Paulo-Pecegueiro/Bode_Analyzer_STM32G474/Firmware/TCC_BODE_ANALYZER_G474/TouchGFX/assets/images/Graphic.png

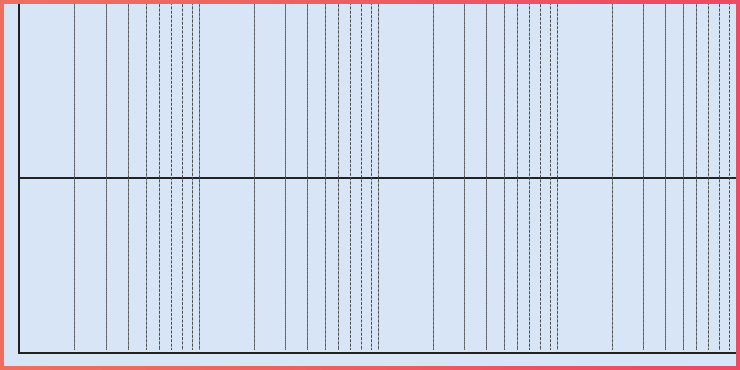
Firmware/TCC_BODE_ANALYZER_G474/TouchGFX/assets/images/Graphic.png
