Paulo-Pecegueiro/Bode_Analyzer_STM32G474/Hardware/Display/Info.png

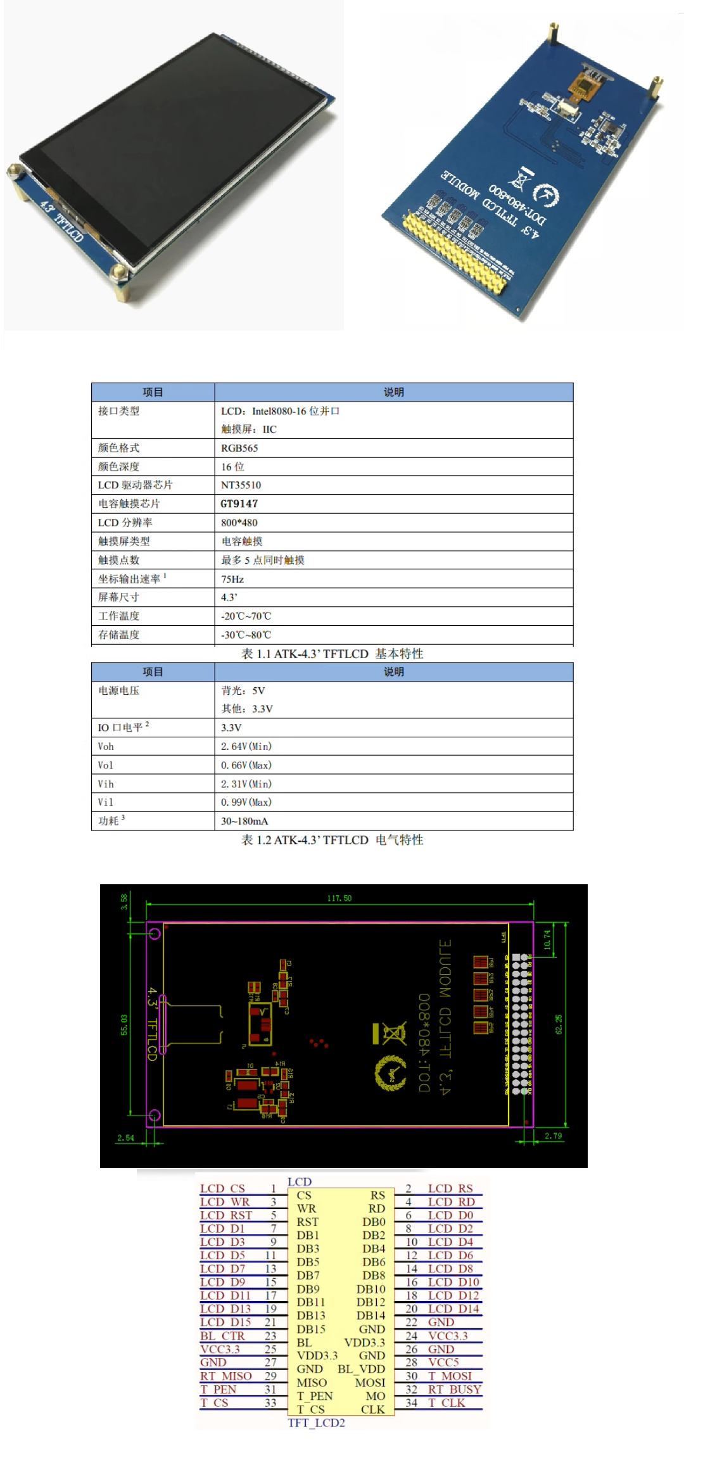
Hardware/Display/Info.png
