Paulo-Pecegueiro/Bode_Analyzer_STM32G474/Hardware/Display/Instituto_Federal_de_São_Paulo_-_Marca_Vertical_2015.bmp

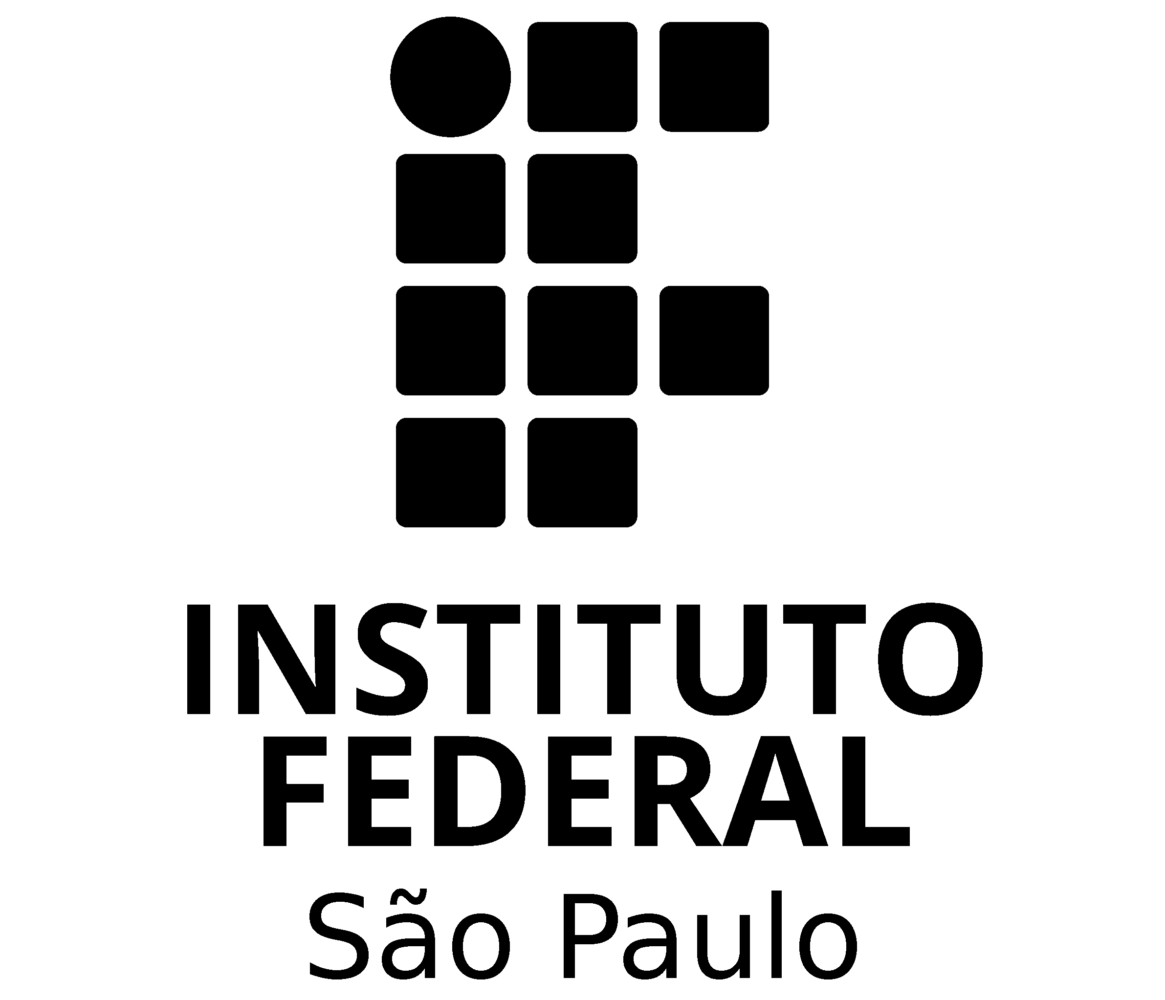
Hardware/Display/Instituto_Federal_de_São_Paulo_-_Marca_Vertical_2015.bmp
