Paulo-Pecegueiro/Bode_Analyzer_STM32G474/Hardware/Production Files/BOM.xlsx

Comment | Designator | Footprint | JLCPCB Part #（optional）
 | C1,C2,C5,C6,C10,C13,C14,C15,C16,C17,C18,C19,C22,C23,C26,C43,C46,C50,C51,C55,C58 | 0603_CAP | C14663
 | C3,C8,C11,C24,C28,C37,C41,C47,C48,C49,C53,C56 | CAPC3216X140 | C96123
 | C4,C7,C9,C12,C25,C29,C38,C40,C42,C45,C52,C54,C57 | CAPC1608X87 | C15849
 | C20,C21 | CAPC1005X55 | C1547
 | C27,C36 | CAPAE830X1080N | C136294
 | C30,C44 | CAPC3216X140 | C23630
 | C31,C32,C33,C34 | CAPC1608X87 | C38523
 | C35 | CAPPRD250W50D630H1270 | C250970
 | C59,C60,C61,C62 | 0603_CAP | C1604
 | R1,R2 | RESC1608X50A | C23186
 | R3 | RESC1608X50A | C21189
 | R4,R39,R40,R41,R42,R43,R44,R45,R46,R47 | RESC1608X50A | C23206
 | R5 | RESC1005X40 | C25079
 | R6,R7,R55,R56,R57,R58,R63,R64,R65,R66 | RESC1608X50A | C22765
 | R8,R9,R10,R11,R12,R13,R14,R15,R16,R17,R18,R19,R20,R21,R22,R23,R24,R25,R26,R27,R28,R29,R30,R31,R32,R33,R34,R35,R36,R37,R38,R48,R49,R50,R51,R52,R53,R54 | RESC1608X50A | C23197
 | R59,R60,R61,R62 | RESC1608X50A | C21189
 | U1 | QFP50P1600X1600X160-100N | C431632
 | U2,U3 | SOT95P280X145-5N | C80670
 | U4 | SOIC127P790X216-8N | C97521
 | U5,U6 | SOIC127P600X175-8 | C63813
 | U8 | SOP65P640X120-20N | C2862562
 | D1 | SOT95P280X145-5N | C490620
 | D2 | DO214 | C8678
 | D3,D4 | SOT23 | C2500
 | B1,B2,B3 | BEADC2012X105N | C1015
 | BOOT,RESET | SKRKAEE020 | C455280
 | DEBUG,STLINK | CONN-SIL4-HIGH ANGLE | MISS
 | IN,OUT | BNC | MISS
 | J1,J2 | CONN-SIL4 | MISS
 | LCD1 | 4.3 TFT L35510 - NO DISPLAY | MISS
 | LED1,LED2 | 0805 | C84256
 | SW1 | SK3296S01L3 | C319019
 | USB | TYPE-C-31-M-12 | C165948
 | X1 | YSX321SL | C2898996
