Paulo-Pecegueiro/Bode_Analyzer_STM32G474/Hardware/Display/Display - Copy.igs

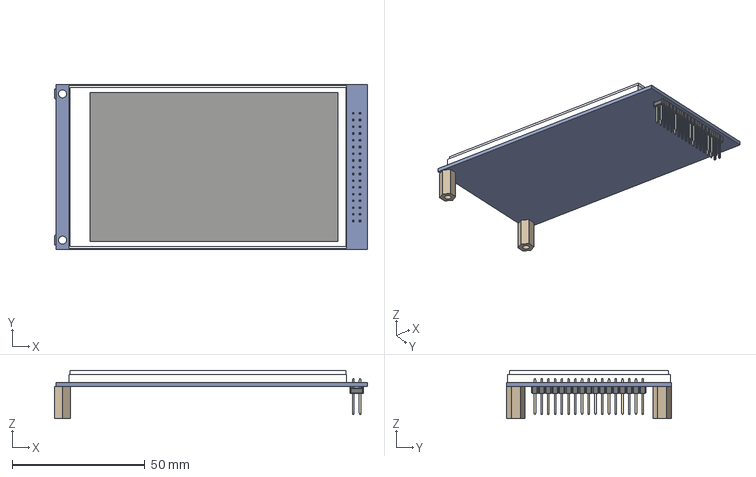
[picture p5: CAD file, 2023-12-21]
Hardware/Display/Display - Copy.igs
118.0 x 62.2 x 18.1 mm
