Paulo-Pecegueiro/Bode_Analyzer_STM32G474/Hardware/Display/2x17 Display  Connector.iges

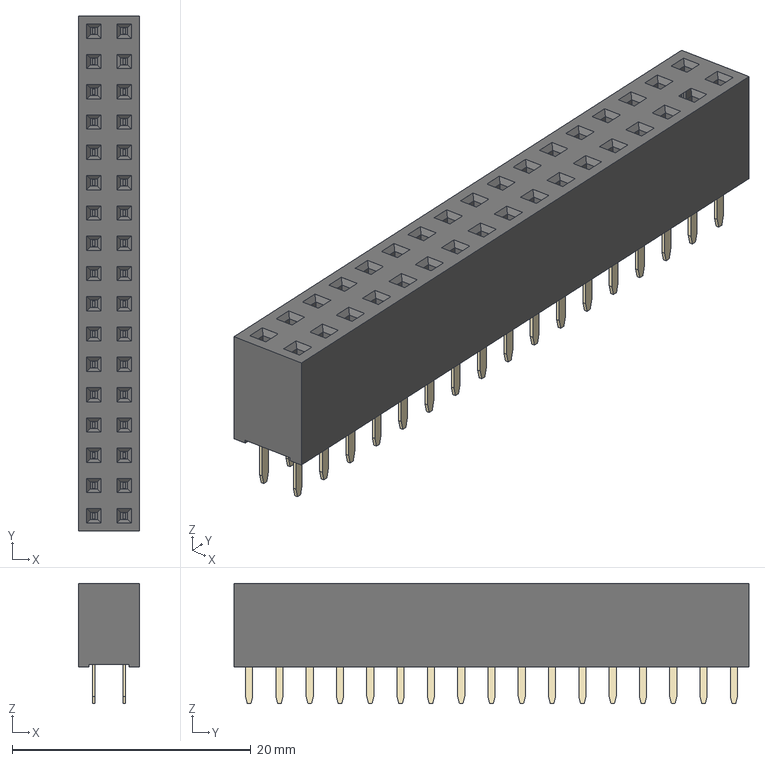
[picture p6: CAD file, 2023-12-21]
Hardware/Display/2x17 Display Connector.iges
5.08 x 43.2 x 10.1 mm
