Paulo-Pecegueiro/Bode_Analyzer_STM32G474/(list of files, cad)

Other CAD files:
Hardware/Display/Display.dwg
