Paulo-Pecegueiro/Bode_Analyzer_STM32G474/Hardware/Production Files/Bode Analyzer.PDF

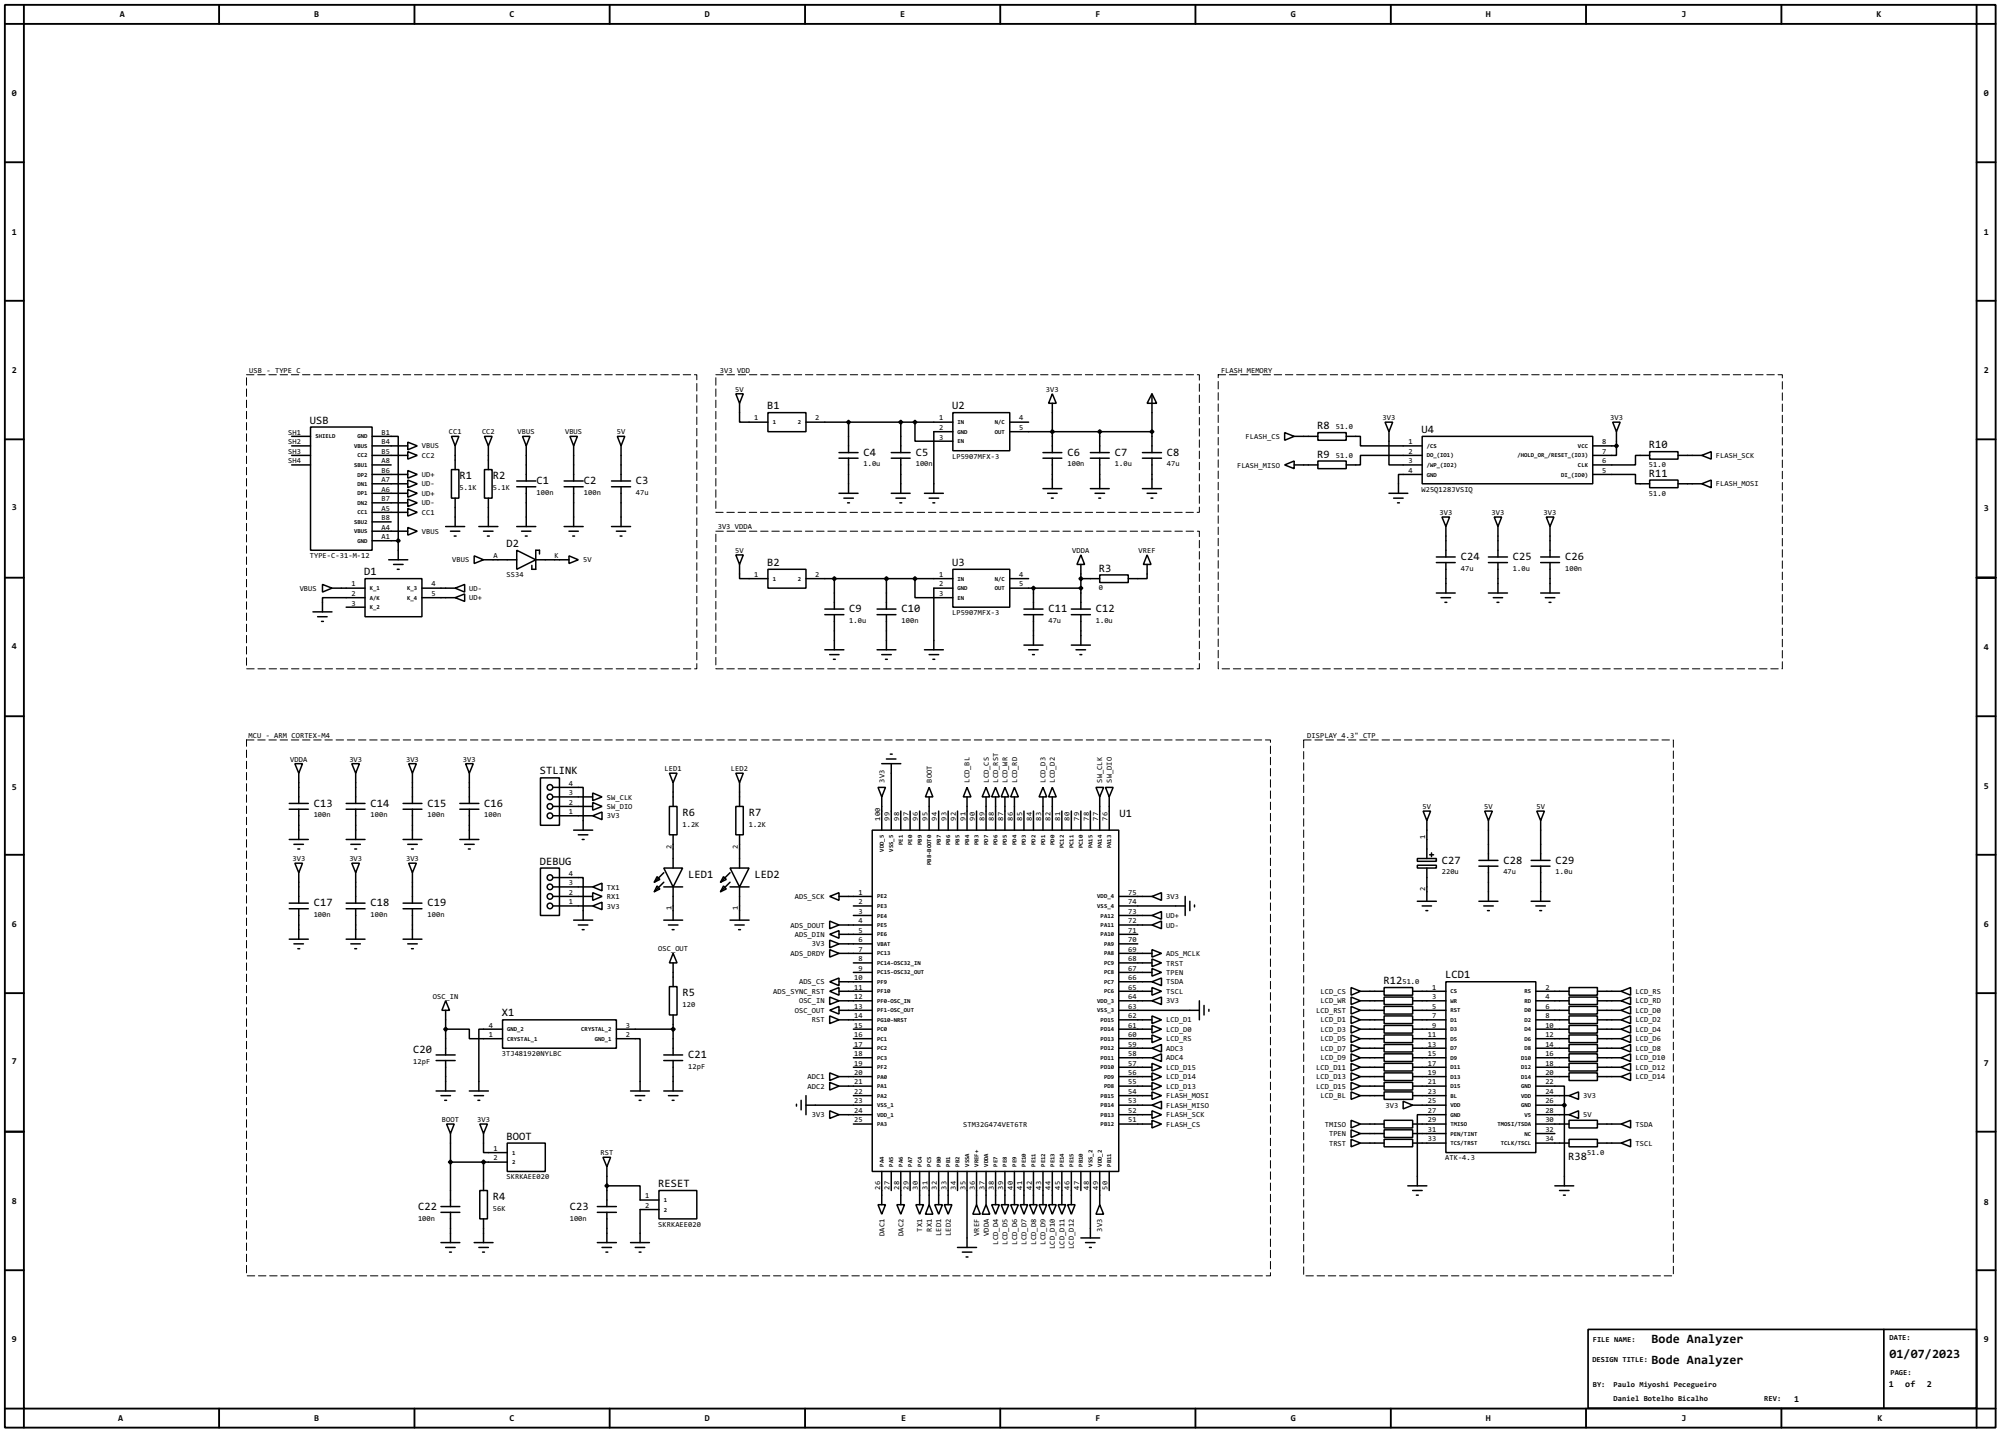
[picture p7: page 1]

DESIGN TITLE: Bode Analyzer

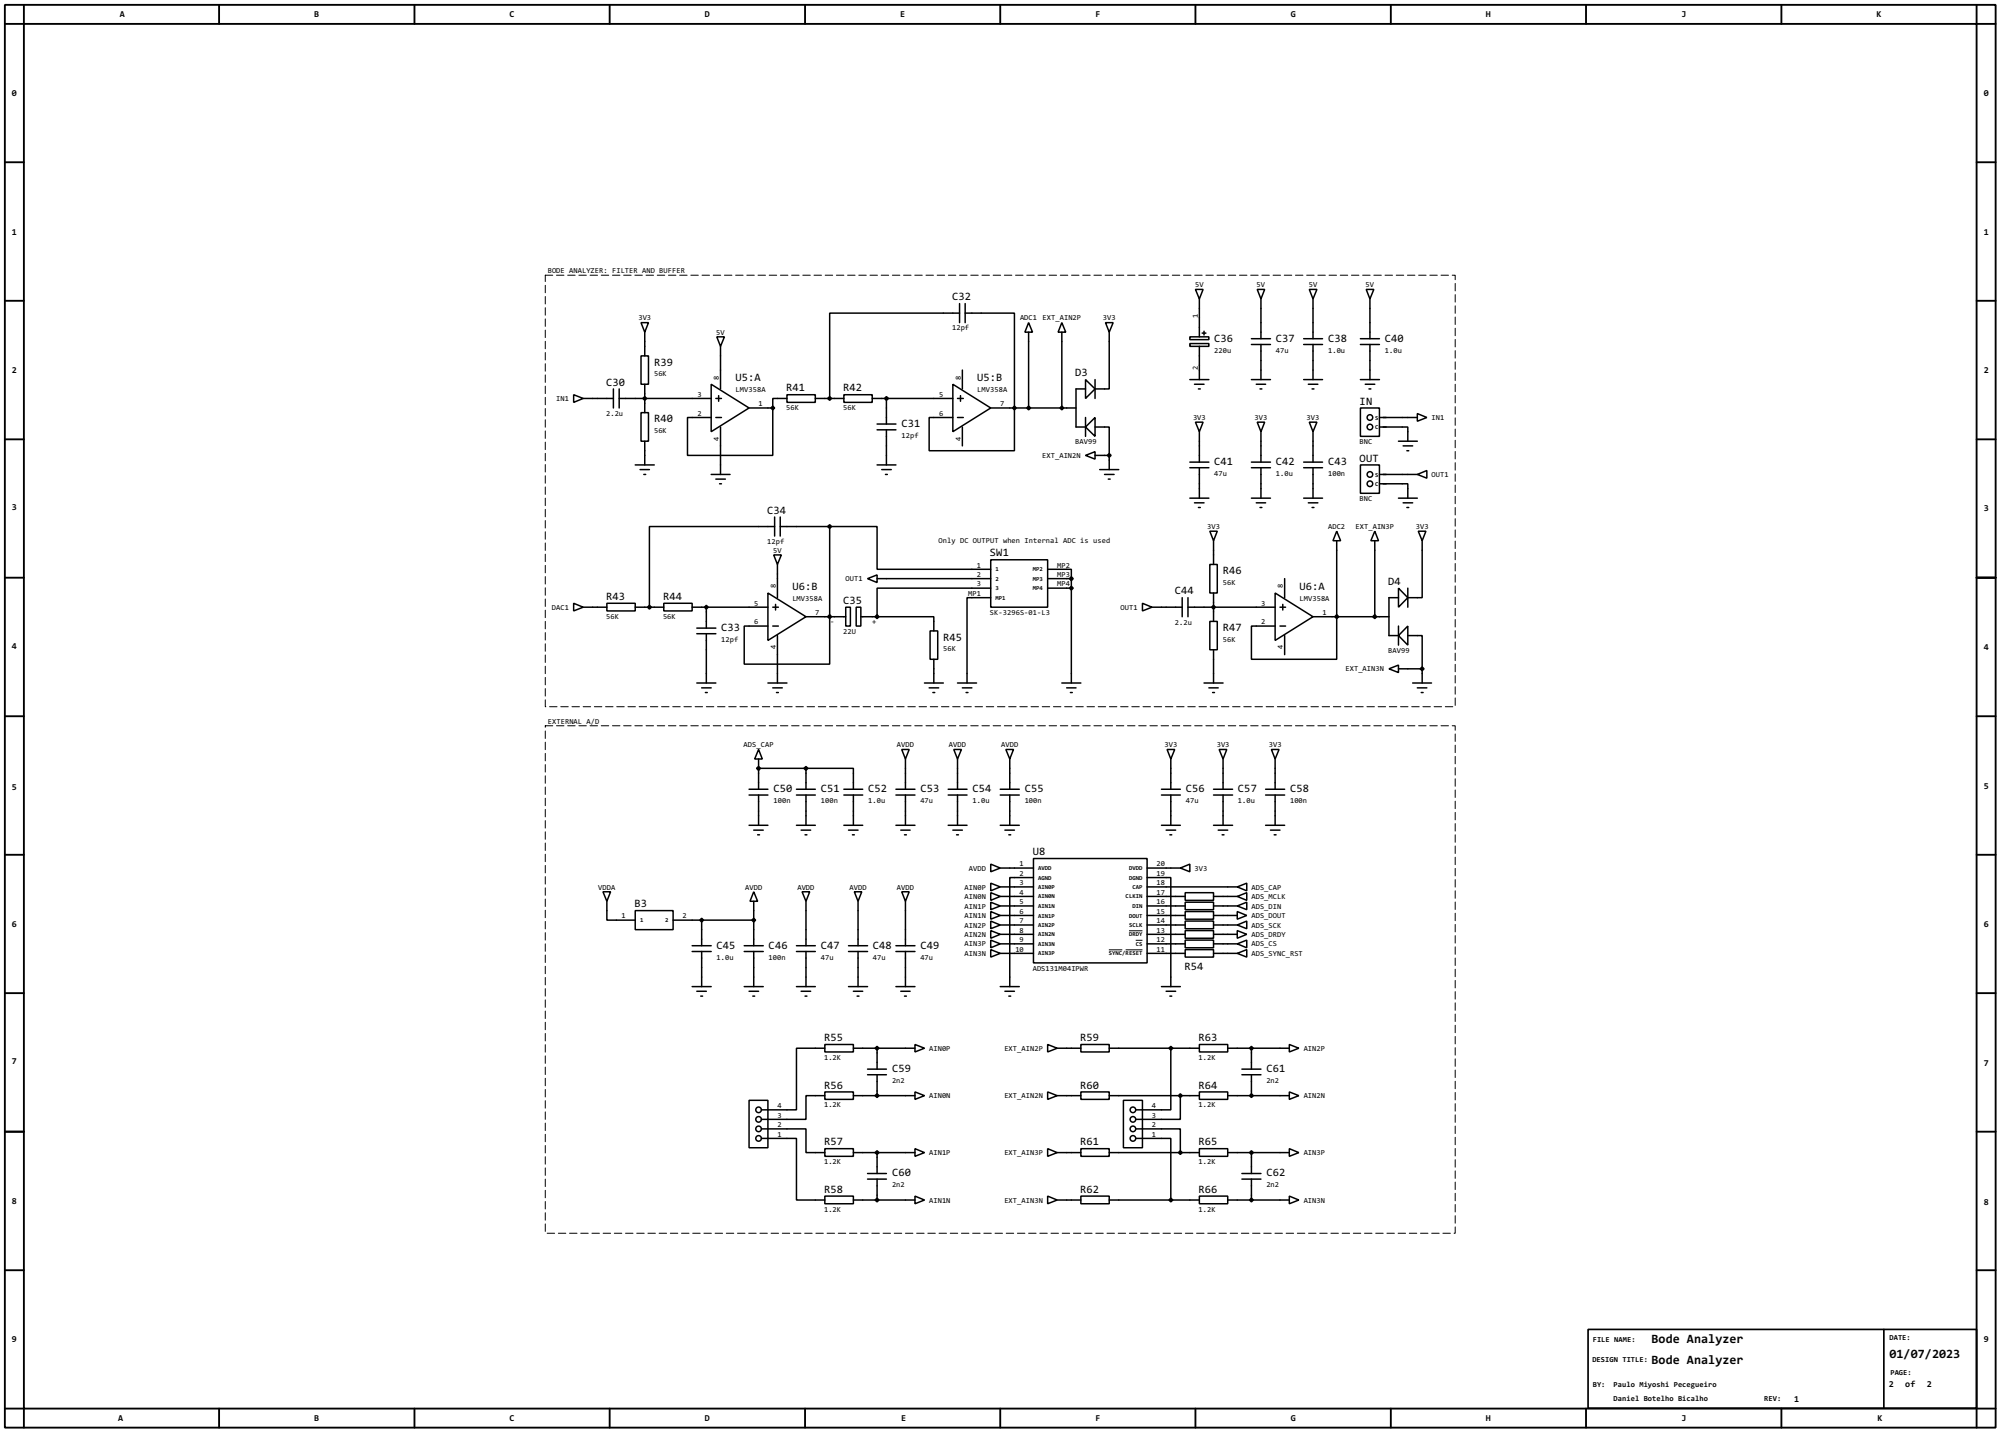
[picture p8: page 2]

BODE ANALYZER: FILTER AND BUFFER

3 3
MP1

DESIGN TITLE: Bode Analyzer
