Paulo-Pecegueiro/Bode_Analyzer_STM32G474/Arquitetura/diagrama de blocos.drawio.pdf

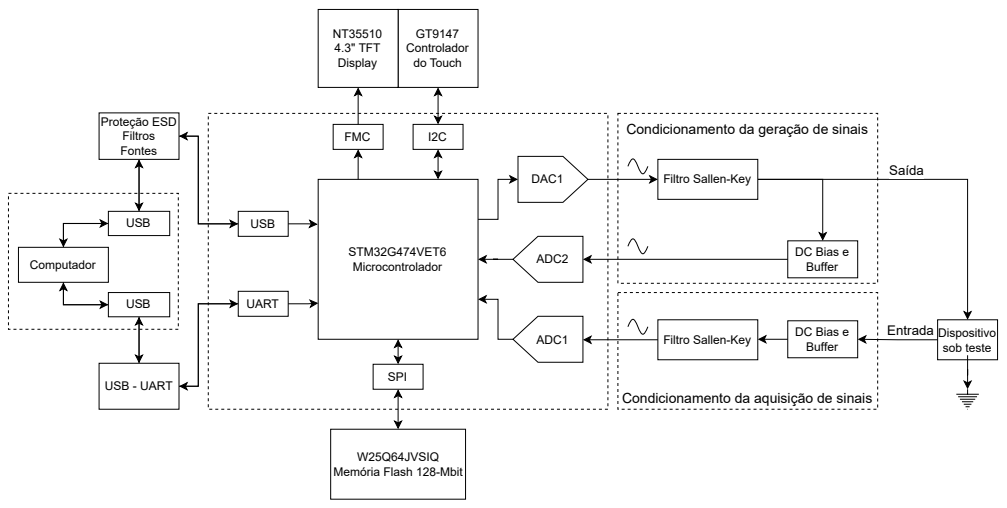
[picture p9: page 1]
STM32G474VET6 Microcontrolador; GT9147 Controlador do Touch; NT35510 4.3" TFT Display; ADC2; DAC1; ADC1; Entrada Dispositivo; sob teste; USB; Computador; SPI; FMC; UART; Saída; Proteção ESD Filtros Fontes; USB - UART; DC Bias e Buffer

Condicionamento da geração de sinais

Filtro Sallen-Key

Condicionamento da aquisição de sinais

W25Q64JVSIQ
Memória Flash 128-Mbit
