Paulo-Pecegueiro/Bode_Analyzer_STM32G474/(list of files, drawings)

Other design files:
Hardware/Hardware.pdsprj
