Paulo-Pecegueiro/Bode_Analyzer_STM32G474/Firmware/TCC_BODE_ANALYZER_G474/TCC_BODE_ANALYZER_G474.ioc

Mcu.UserName=STM32G474VETx
PA0.GPIO_Label=ADC1
PA0.Signal=ADC1_IN1
PA1.GPIO_Label=ADC2
PA1.Signal=ADC2_IN2
PA11.Signal=USB_DM
PA12.Signal=USB_DP
PA13.Signal=SYS_JTMS-SWDIO
PA14.Signal=SYS_JTCK-SWCLK
PA4.GPIO_Label=DAC1
PA4.Signal=COMP_DAC11_group
PB0.GPIO_Label=LED1
PB0.Signal=GPIO_Output
PB1.GPIO_Label=LED2
PB1.Signal=GPIO_Output
PB12.GPIO_Label=FLASH_CS
PB12.Signal=GPIO_Output
PB13.GPIO_Label=FLASH_SCK
PB13.Signal=SPI2_SCK
PB14.GPIO_Label=FLASH_MISO
PB14.Signal=SPI2_MISO
PB15.GPIO_Label=FLASH_MOSI
PB15.Signal=SPI2_MOSI
PB4.GPIO_Label=LCD_BL
PB4.Signal=S_TIM3_CH1
PC6.GPIO_Label=TSCL
PC6.Signal=I2C4_SCL
PC7.GPIO_Label=TSDA
PC7.Signal=I2C4_SDA
PC8.GPIO_Label=TPEN
PC8.Signal=GPXTI8
PC9.GPIO_Label=TRST
PC9.Signal=GPIO_Output
PD0.GPIO_Label=LCD_D2
PD0.Signal=FMC_D2
PD1.GPIO_Label=LCD_D3
PD1.Signal=FMC_D3
PD10.GPIO_Label=LCD_D15
PD10.Signal=FMC_D15
PD13.GPIO_Label=LCD_RS
PD13.Signal=FMC_A18
PD14.GPIO_Label=LCD_D0
PD14.Signal=FMC_D0
PD15.GPIO_Label=LCD_D1
PD15.Signal=FMC_D1
PD4.GPIO_Label=LCD_RD
PD4.Signal=FMC_NOE
PD5.GPIO_Label=LCD_WR
PD5.Signal=FMC_NWE
PD6.GPIO_Label=LCD_RST
PD6.Signal=GPIO_Output
PD7.GPIO_Label=LCD_CS
PD7.Signal=FMC_NE1
PD8.GPIO_Label=LCD_D13
PD8.Signal=FMC_D13
PD9.GPIO_Label=LCD_D14
PD9.Signal=FMC_D14
PE10.GPIO_Label=LCD_D7
PE10.Signal=FMC_D7
PE11.GPIO_Label=LCD_D8
PE11.Signal=FMC_D8
PE12.GPIO_Label=LCD_D9
PE12.Signal=FMC_D9
PE13.GPIO_Label=LCD_D10
PE13.Signal=FMC_D10
PE14.GPIO_Label=LCD_D11
PE14.Signal=FMC_D11
PE15.GPIO_Label=LCD_D12
PE15.Signal=FMC_D12
PE7.GPIO_Label=LCD_D4
PE7.Signal=FMC_D4
PE8.GPIO_Label=LCD_D5
PE8.Signal=FMC_D5
PE9.GPIO_Label=LCD_D6
PE9.Signal=FMC_D6
