Paulo-Pecegueiro/Bode_Analyzer_STM32G474/Firmware/TCC_BODE_ANALYZER_G474/Drivers/NT35510/NT35510.c

/* Includes ------------------------------------------------------------------*/
#include "NT35510.h"
#include "dma.h"
#include "tim.h"

#define RTOS_ENABLED  1

#if RTOS_ENABLED == 1
#include "cmsis_os.h"
#endif

/* Defines -------------------------------------------------------------------*/
#define LCD_BASE       	0x60000000
#define LCD_RAM        	0x60080000

#define DMA_HANDLE		hdma_memtomem_dma1_channel3
#define DMA_TXCALLBACK 	TransferCompleteDMACallback
#define TIM_HANDLE		TIM3
#define TIM_CHANNEL		TIM_CHANNEL_1
/* Private types -------------------------------------------------------------*/


/* Private variables ---------------------------------------------------------*/
FlagStatus __isTranmittingBlock = RESET;
const uint16_t fade[128] = {
		0, 0, 0, 0, 0, 0, 1, 1, 1, 1,
		1, 2, 2, 2, 2, 3, 3, 3, 4, 4,
		4, 5, 5, 5, 6, 6, 7, 7, 8, 8,
		9, 9, 10, 11, 11, 12, 13, 13, 14, 15,
		16, 17, 18, 19, 20, 21, 22, 23, 24, 26,
		27, 28, 30, 31, 33, 35, 36, 38, 40, 42,
		44, 47, 49, 51, 54, 57, 59, 62, 65, 68,
		72, 75, 79, 83, 87, 91, 95, 100, 105, 110,
		115, 121, 126, 132, 139, 145, 152, 160, 167, 175,
		183, 192, 201, 211, 220, 231, 242, 253, 265, 278,
		291, 304, 319, 334, 349, 366, 383, 401, 419, 439,
		460, 481, 504, 527, 552, 578, 605, 633, 662, 693,
		726, 760, 795, 832, 871, 912, 954, 999};

/* Private constants ---------------------------------------------------------*/
/* Private macros ------------------------------------------------------------*/
/* Imported function Prototypes ----------------------------------------------*/
void TransferCompleteDMACallback(DMA_HandleTypeDef * hdma);
void DisplayDriver_TransferCompleteCallback();

/* Privated functions --------------------------------------------------------*/
void LCD_WR_REG(uint16_t data)
{
	*(uint16_t *)LCD_BASE = data;
}

void LCD_WR_DATA(uint16_t data)
{
	*(uint16_t *)LCD_RAM = data;
}

uint16_t LCD_RD_DATA(void)
{
	return *(uint16_t *)LCD_RAM;
}

void LCD_Delay(uint32_t time)
{
#if RTOS_ENABLED == 1
	osDelay(time);
#else
	HAL_Delay(time);
#endif
}

void TransferCompleteDMACallback(DMA_HandleTypeDef * hdma)
{
	__HAL_DMA_CLEAR_FLAG(&DMA_HANDLE, DMA_FLAG_TC1);

	__HAL_DMA_DISABLE(&DMA_HANDLE);

	__isTranmittingBlock = RESET;

	DisplayDriver_TransferCompleteCallback();
}

void NT35510_Gamma_Correction(void)
{
		/* MAUCCTR: Enable the Manufacture Command Set Selection - Page 1 */
	LCD_WR_REG(0xF000); LCD_WR_DATA(0x55);
	LCD_WR_REG(0xF001); LCD_WR_DATA(0xAA);
	LCD_WR_REG(0xF002); LCD_WR_DATA(0x52);
	LCD_WR_REG(0xF003); LCD_WR_DATA(0x08);
	LCD_WR_REG(0xF004); LCD_WR_DATA(0x01);

	/* BT1CTR: Power Control for AVDD */
	LCD_WR_REG(0xB600); LCD_WR_DATA(0x34);
	LCD_WR_REG(0xB601); LCD_WR_DATA(0x34);
	LCD_WR_REG(0xB602); LCD_WR_DATA(0x34);

	/* SETAVDD: Setting AVDD Voltage */
	LCD_WR_REG(0xB000); LCD_WR_DATA(0x0D);
	LCD_WR_REG(0xB001); LCD_WR_DATA(0x0D);
	LCD_WR_REG(0xB002); LCD_WR_DATA(0x0D);

	/* BT2CTR Power Control for AVEE */
	LCD_WR_REG(0xB700); LCD_WR_DATA(0x24);
	LCD_WR_REG(0xB701); LCD_WR_DATA(0x24);
	LCD_WR_REG(0xB702); LCD_WR_DATA(0x24);

	/* SETAVEE: Setting AVEE Voltage */
	LCD_WR_REG(0xB100); LCD_WR_DATA(0x0D);
	LCD_WR_REG(0xB101); LCD_WR_DATA(0x0D);
	LCD_WR_REG(0xB102); LCD_WR_DATA(0x0D);

	/* BT3CTR: Power Control for VCL */
	LCD_WR_REG(0xB800); LCD_WR_DATA(0x24);
	LCD_WR_REG(0xB801); LCD_WR_DATA(0x24);
	LCD_WR_REG(0xB802); LCD_WR_DATA(0x24);

	/* SETVCL: Setting VCL Voltage */
	LCD_WR_REG(0xB200); LCD_WR_DATA(0x00);

	/* BT4CTR: Power Control for VGH */
	LCD_WR_REG(0xB900); LCD_WR_DATA(0x24);
	LCD_WR_REG(0xB901); LCD_WR_DATA(0x24);
	LCD_WR_REG(0xB902); LCD_WR_DATA(0x24);

	/* ?  */
	LCD_WR_REG(0xB300); LCD_WR_DATA(0x05);
	LCD_WR_REG(0xB301); LCD_WR_DATA(0x05);
	LCD_WR_REG(0xB302); LCD_WR_DATA(0x05);

	/* ? */
	//LCD_WR_REG(0xBF00); LCD_WR_DATA(0x01);

	/* BT5CTR: Power Control for VGLX */
	LCD_WR_REG(0xBA00); LCD_WR_DATA(0x34);
	LCD_WR_REG(0xBA01); LCD_WR_DATA(0x34);
	LCD_WR_REG(0xBA02); LCD_WR_DATA(0x34);

	/* ? */
	LCD_WR_REG(0xB500); LCD_WR_DATA(0x0B);
	LCD_WR_REG(0xB501); LCD_WR_DATA(0x0B);
	LCD_WR_REG(0xB502); LCD_WR_DATA(0x0B);

	/* STVGP: Setting VGMP and VGSP Voltage */
	LCD_WR_REG(0xBC00); LCD_WR_DATA(0X00);
	LCD_WR_REG(0xBC01); LCD_WR_DATA(0xA3);
	LCD_WR_REG(0xBC02); LCD_WR_DATA(0X00);

	/* SETVGN: Setting VGMN and VGSN Voltage */
	LCD_WR_REG(0xBD00); LCD_WR_DATA(0x00);
	LCD_WR_REG(0xBD01); LCD_WR_DATA(0xA3);
	LCD_WR_REG(0xBD02); LCD_WR_DATA(0x00);

	/* STVCMOFF: Setting VCOM Offset Voltage */
	LCD_WR_REG(0xBE00); LCD_WR_DATA(0x00);
	LCD_WR_REG(0xBE01); LCD_WR_DATA(0x63);

	/* GMRCTR1: Setting Gamma 2.2 Correction for Red (Positive) */
	LCD_WR_REG(0xD100); LCD_WR_DATA(0x00);
	LCD_WR_REG(0xD101); LCD_WR_DATA(0x37);
	LCD_WR_REG(0xD102); LCD_WR_DATA(0x00);
	LCD_WR_REG(0xD103); LCD_WR_DATA(0x52);
	LCD_WR_REG(0xD104); LCD_WR_DATA(0x00);
	LCD_WR_REG(0xD105); LCD_WR_DATA(0x7B);
	LCD_WR_REG(0xD106); LCD_WR_DATA(0x00);
	LCD_WR_REG(0xD107); LCD_WR_DATA(0x99);
	LCD_WR_REG(0xD108); LCD_WR_DATA(0x00);
	LCD_WR_REG(0xD109); LCD_WR_DATA(0xB1);
	LCD_WR_REG(0xD10A); LCD_WR_DATA(0x00);
	LCD_WR_REG(0xD10B); LCD_WR_DATA(0xD2);
	LCD_WR_REG(0xD10C); LCD_WR_DATA(0x00);
	LCD_WR_REG(0xD10D); LCD_WR_DATA(0xF6);
	LCD_WR_REG(0xD10E); LCD_WR_DATA(0x01);
	LCD_WR_REG(0xD10F); LCD_WR_DATA(0x27);
	LCD_WR_REG(0xD110); LCD_WR_DATA(0x01);
	LCD_WR_REG(0xD111); LCD_WR_DATA(0x4E);
	LCD_WR_REG(0xD112); LCD_WR_DATA(0x01);
	LCD_WR_REG(0xD113); LCD_WR_DATA(0x8C);
	LCD_WR_REG(0xD114); LCD_WR_DATA(0x01);
	LCD_WR_REG(0xD115); LCD_WR_DATA(0xBE);
	LCD_WR_REG(0xD116); LCD_WR_DATA(0x02);
	LCD_WR_REG(0xD117); LCD_WR_DATA(0x0B);
	LCD_WR_REG(0xD118); LCD_WR_DATA(0x02);
	LCD_WR_REG(0xD119); LCD_WR_DATA(0x48);
	LCD_WR_REG(0xD11A); LCD_WR_DATA(0x02);
	LCD_WR_REG(0xD11B); LCD_WR_DATA(0x4A);
	LCD_WR_REG(0xD11C); LCD_WR_DATA(0x02);
	LCD_WR_REG(0xD11D); LCD_WR_DATA(0x7E);
	LCD_WR_REG(0xD11E); LCD_WR_DATA(0x02);
	LCD_WR_REG(0xD11F); LCD_WR_DATA(0xBC);
	LCD_WR_REG(0xD120); LCD_WR_DATA(0x02);
	LCD_WR_REG(0xD121); LCD_WR_DATA(0xE1);
	LCD_WR_REG(0xD122); LCD_WR_DATA(0x03);
	LCD_WR_REG(0xD123); LCD_WR_DATA(0x10);
	LCD_WR_REG(0xD124); LCD_WR_DATA(0x03);
	LCD_WR_REG(0xD125); LCD_WR_DATA(0x31);
	LCD_WR_REG(0xD126); LCD_WR_DATA(0x03);
	LCD_WR_REG(0xD127); LCD_WR_DATA(0x5A);
	LCD_WR_REG(0xD128); LCD_WR_DATA(0x03);
	LCD_WR_REG(0xD129); LCD_WR_DATA(0x73);
	LCD_WR_REG(0xD12A); LCD_WR_DATA(0x03);
	LCD_WR_REG(0xD12B); LCD_WR_DATA(0x94);
	LCD_WR_REG(0xD12C); LCD_WR_DATA(0x03);
	LCD_WR_REG(0xD12D); LCD_WR_DATA(0x9F);
	LCD_WR_REG(0xD12E); LCD_WR_DATA(0x03);
	LCD_WR_REG(0xD12F); LCD_WR_DATA(0xB3);
	LCD_WR_REG(0xD130); LCD_WR_DATA(0x03);
	LCD_WR_REG(0xD131); LCD_WR_DATA(0xB9);
	LCD_WR_REG(0xD132); LCD_WR_DATA(0x03);
	LCD_WR_REG(0xD133); LCD_WR_DATA(0xC1);

	/* GMGCTR1: Setting Gamma 2.2 Correction for Green (Positive) */
	LCD_WR_REG(0xD200); LCD_WR_DATA(0x00);
	LCD_WR_REG(0xD201); LCD_WR_DATA(0x37);
	LCD_WR_REG(0xD202); LCD_WR_DATA(0x00);
	LCD_WR_REG(0xD203); LCD_WR_DATA(0x52);
	LCD_WR_REG(0xD204); LCD_WR_DATA(0x00);
	LCD_WR_REG(0xD205); LCD_WR_DATA(0x7B);
	LCD_WR_REG(0xD206); LCD_WR_DATA(0x00);
	LCD_WR_REG(0xD207); LCD_WR_DATA(0x99);
	LCD_WR_REG(0xD208); LCD_WR_DATA(0x00);
	LCD_WR_REG(0xD209); LCD_WR_DATA(0xB1);
	LCD_WR_REG(0xD20A); LCD_WR_DATA(0x00);
	LCD_WR_REG(0xD20B); LCD_WR_DATA(0xD2);
	LCD_WR_REG(0xD20C); LCD_WR_DATA(0x00);
	LCD_WR_REG(0xD20D); LCD_WR_DATA(0xF6);
	LCD_WR_REG(0xD20E); LCD_WR_DATA(0x01);
	LCD_WR_REG(0xD20F); LCD_WR_DATA(0x27);
	LCD_WR_REG(0xD210); LCD_WR_DATA(0x01);
	LCD_WR_REG(0xD211); LCD_WR_DATA(0x4E);
	LCD_WR_REG(0xD212); LCD_WR_DATA(0x01);
	LCD_WR_REG(0xD213); LCD_WR_DATA(0x8C);
	LCD_WR_REG(0xD214); LCD_WR_DATA(0x01);
	LCD_WR_REG(0xD215); LCD_WR_DATA(0xBE);
	LCD_WR_REG(0xD216); LCD_WR_DATA(0x02);
	LCD_WR_REG(0xD217); LCD_WR_DATA(0x0B);
	LCD_WR_REG(0xD218); LCD_WR_DATA(0x02);
	LCD_WR_REG(0xD219); LCD_WR_DATA(0x48);
	LCD_WR_REG(0xD21A); LCD_WR_DATA(0x02);
	LCD_WR_REG(0xD21B); LCD_WR_DATA(0x4A);
	LCD_WR_REG(0xD21C); LCD_WR_DATA(0x02);
	LCD_WR_REG(0xD21D); LCD_WR_DATA(0x7E);
	LCD_WR_REG(0xD21E); LCD_WR_DATA(0x02);
	LCD_WR_REG(0xD21F); LCD_WR_DATA(0xBC);
	LCD_WR_REG(0xD220); LCD_WR_DATA(0x02);
	LCD_WR_REG(0xD221); LCD_WR_DATA(0xE1);
	LCD_WR_REG(0xD222); LCD_WR_DATA(0x03);
	LCD_WR_REG(0xD223); LCD_WR_DATA(0x10);
	LCD_WR_REG(0xD224); LCD_WR_DATA(0x03);
	LCD_WR_REG(0xD225); LCD_WR_DATA(0x31);
	LCD_WR_REG(0xD226); LCD_WR_DATA(0x03);
	LCD_WR_REG(0xD227); LCD_WR_DATA(0x5A);
	LCD_WR_REG(0xD228); LCD_WR_DATA(0x03);
	LCD_WR_REG(0xD229); LCD_WR_DATA(0x73);
	LCD_WR_REG(0xD22A); LCD_WR_DATA(0x03);
	LCD_WR_REG(0xD22B); LCD_WR_DATA(0x94);
	LCD_WR_REG(0xD22C); LCD_WR_DATA(0x03);
	LCD_WR_REG(0xD22D); LCD_WR_DATA(0x9F);
	LCD_WR_REG(0xD22E); LCD_WR_DATA(0x03);
	LCD_WR_REG(0xD22F); LCD_WR_DATA(0xB3);
	LCD_WR_REG(0xD230); LCD_WR_DATA(0x03);
	LCD_WR_REG(0xD231); LCD_WR_DATA(0xB9);
	LCD_WR_REG(0xD232); LCD_WR_DATA(0x03);
	LCD_WR_REG(0xD233); LCD_WR_DATA(0xC1);

	/* GMBCTR1: Setting Gamma 2.2 Correction for Blue (Positive) */
	LCD_WR_REG(0xD300); LCD_WR_DATA(0x00);
	LCD_WR_REG(0xD301); LCD_WR_DATA(0x37);
	LCD_WR_REG(0xD302); LCD_WR_DATA(0x00);
	LCD_WR_REG(0xD303); LCD_WR_DATA(0x52);
	LCD_WR_REG(0xD304); LCD_WR_DATA(0x00);
	LCD_WR_REG(0xD305); LCD_WR_DATA(0x7B);
	LCD_WR_REG(0xD306); LCD_WR_DATA(0x00);
	LCD_WR_REG(0xD307); LCD_WR_DATA(0x99);
	LCD_WR_REG(0xD308); LCD_WR_DATA(0x00);
	LCD_WR_REG(0xD309); LCD_WR_DATA(0xB1);
	LCD_WR_REG(0xD30A); LCD_WR_DATA(0x00);
	LCD_WR_REG(0xD30B); LCD_WR_DATA(0xD2);
	LCD_WR_REG(0xD30C); LCD_WR_DATA(0x00);
	LCD_WR_REG(0xD30D); LCD_WR_DATA(0xF6);
	LCD_WR_REG(0xD30E); LCD_WR_DATA(0x01);
	LCD_WR_REG(0xD30F); LCD_WR_DATA(0x27);
	LCD_WR_REG(0xD310); LCD_WR_DATA(0x01);
	LCD_WR_REG(0xD311); LCD_WR_DATA(0x4E);
	LCD_WR_REG(0xD312); LCD_WR_DATA(0x01);
	LCD_WR_REG(0xD313); LCD_WR_DATA(0x8C);
	LCD_WR_REG(0xD314); LCD_WR_DATA(0x01);
	LCD_WR_REG(0xD315); LCD_WR_DATA(0xBE);
	LCD_WR_REG(0xD316); LCD_WR_DATA(0x02);
	LCD_WR_REG(0xD317); LCD_WR_DATA(0x0B);
	LCD_WR_REG(0xD318); LCD_WR_DATA(0x02);
	LCD_WR_REG(0xD319); LCD_WR_DATA(0x48);
	LCD_WR_REG(0xD31A); LCD_WR_DATA(0x02);
	LCD_WR_REG(0xD31B); LCD_WR_DATA(0x4A);
	LCD_WR_REG(0xD31C); LCD_WR_DATA(0x02);
	LCD_WR_REG(0xD31D); LCD_WR_DATA(0x7E);
	LCD_WR_REG(0xD31E); LCD_WR_DATA(0x02);
	LCD_WR_REG(0xD31F); LCD_WR_DATA(0xBC);
	LCD_WR_REG(0xD320); LCD_WR_DATA(0x02);
	LCD_WR_REG(0xD321); LCD_WR_DATA(0xE1);
	LCD_WR_REG(0xD322); LCD_WR_DATA(0x03);
	LCD_WR_REG(0xD323); LCD_WR_DATA(0x10);
	LCD_WR_REG(0xD324); LCD_WR_DATA(0x03);
	LCD_WR_REG(0xD325); LCD_WR_DATA(0x31);
	LCD_WR_REG(0xD326); LCD_WR_DATA(0x03);
	LCD_WR_REG(0xD327); LCD_WR_DATA(0x5A);
	LCD_WR_REG(0xD328); LCD_WR_DATA(0x03);
	LCD_WR_REG(0xD329); LCD_WR_DATA(0x73);
	LCD_WR_REG(0xD32A); LCD_WR_DATA(0x03);
	LCD_WR_REG(0xD32B); LCD_WR_DATA(0x94);
	LCD_WR_REG(0xD32C); LCD_WR_DATA(0x03);
	LCD_WR_REG(0xD32D); LCD_WR_DATA(0x9F);
	LCD_WR_REG(0xD32E); LCD_WR_DATA(0x03);
	LCD_WR_REG(0xD32F); LCD_WR_DATA(0xB3);
	LCD_WR_REG(0xD330); LCD_WR_DATA(0x03);
	LCD_WR_REG(0xD331); LCD_WR_DATA(0xB9);
	LCD_WR_REG(0xD332); LCD_WR_DATA(0x03);
	LCD_WR_REG(0xD333); LCD_WR_DATA(0xC1);

	/* GMRCTR2: Setting Gamma 2.2 Correction for Red (Negative) */
	LCD_WR_REG(0xD400); LCD_WR_DATA(0x00);
	LCD_WR_REG(0xD401); LCD_WR_DATA(0x37);
	LCD_WR_REG(0xD402); LCD_WR_DATA(0x00);
	LCD_WR_REG(0xD403); LCD_WR_DATA(0x52);
	LCD_WR_REG(0xD404); LCD_WR_DATA(0x00);
	LCD_WR_REG(0xD405); LCD_WR_DATA(0x7B);
	LCD_WR_REG(0xD406); LCD_WR_DATA(0x00);
	LCD_WR_REG(0xD407); LCD_WR_DATA(0x99);
	LCD_WR_REG(0xD408); LCD_WR_DATA(0x00);
	LCD_WR_REG(0xD409); LCD_WR_DATA(0xB1);
	LCD_WR_REG(0xD40A); LCD_WR_DATA(0x00);
	LCD_WR_REG(0xD40B); LCD_WR_DATA(0xD2);
	LCD_WR_REG(0xD40C); LCD_WR_DATA(0x00);
	LCD_WR_REG(0xD40D); LCD_WR_DATA(0xF6);
	LCD_WR_REG(0xD40E); LCD_WR_DATA(0x01);
	LCD_WR_REG(0xD40F); LCD_WR_DATA(0x27);
	LCD_WR_REG(0xD410); LCD_WR_DATA(0x01);
	LCD_WR_REG(0xD411); LCD_WR_DATA(0x4E);
	LCD_WR_REG(0xD412); LCD_WR_DATA(0x01);
	LCD_WR_REG(0xD413); LCD_WR_DATA(0x8C);
	LCD_WR_REG(0xD414); LCD_WR_DATA(0x01);
	LCD_WR_REG(0xD415); LCD_WR_DATA(0xBE);
	LCD_WR_REG(0xD416); LCD_WR_DATA(0x02);
	LCD_WR_REG(0xD417); LCD_WR_DATA(0x0B);
	LCD_WR_REG(0xD418); LCD_WR_DATA(0x02);
	LCD_WR_REG(0xD419); LCD_WR_DATA(0x48);
	LCD_WR_REG(0xD41A); LCD_WR_DATA(0x02);
	LCD_WR_REG(0xD41B); LCD_WR_DATA(0x4A);
	LCD_WR_REG(0xD41C); LCD_WR_DATA(0x02);
	LCD_WR_REG(0xD41D); LCD_WR_DATA(0x7E);
	LCD_WR_REG(0xD41E); LCD_WR_DATA(0x02);
	LCD_WR_REG(0xD41F); LCD_WR_DATA(0xBC);
	LCD_WR_REG(0xD420); LCD_WR_DATA(0x02);
	LCD_WR_REG(0xD421); LCD_WR_DATA(0xE1);
	LCD_WR_REG(0xD422); LCD_WR_DATA(0x03);
	LCD_WR_REG(0xD423); LCD_WR_DATA(0x10);
	LCD_WR_REG(0xD424); LCD_WR_DATA(0x03);
	LCD_WR_REG(0xD425); LCD_WR_DATA(0x31);
	LCD_WR_REG(0xD426); LCD_WR_DATA(0x03);
	LCD_WR_REG(0xD427); LCD_WR_DATA(0x5A);
	LCD_WR_REG(0xD428); LCD_WR_DATA(0x03);
	LCD_WR_REG(0xD429); LCD_WR_DATA(0x73);
	LCD_WR_REG(0xD42A); LCD_WR_DATA(0x03);
	LCD_WR_REG(0xD42B); LCD_WR_DATA(0x94);
	LCD_WR_REG(0xD42C); LCD_WR_DATA(0x03);
	LCD_WR_REG(0xD42D); LCD_WR_DATA(0x9F);
	LCD_WR_REG(0xD42E); LCD_WR_DATA(0x03);
	LCD_WR_REG(0xD42F); LCD_WR_DATA(0xB3);
	LCD_WR_REG(0xD430); LCD_WR_DATA(0x03);
	LCD_WR_REG(0xD431); LCD_WR_DATA(0xB9);
	LCD_WR_REG(0xD432); LCD_WR_DATA(0x03);
	LCD_WR_REG(0xD433); LCD_WR_DATA(0xC1);

	/* GMGCTR2: Setting Gamma 2.2 Correction for Green */
	LCD_WR_REG(0xD500); LCD_WR_DATA(0x00);
	LCD_WR_REG(0xD501); LCD_WR_DATA(0x37);
	LCD_WR_REG(0xD502); LCD_WR_DATA(0x00);
	LCD_WR_REG(0xD503); LCD_WR_DATA(0x52);
	LCD_WR_REG(0xD504); LCD_WR_DATA(0x00);
	LCD_WR_REG(0xD505); LCD_WR_DATA(0x7B);
	LCD_WR_REG(0xD506); LCD_WR_DATA(0x00);
	LCD_WR_REG(0xD507); LCD_WR_DATA(0x99);
	LCD_WR_REG(0xD508); LCD_WR_DATA(0x00);
	LCD_WR_REG(0xD509); LCD_WR_DATA(0xB1);
	LCD_WR_REG(0xD50A); LCD_WR_DATA(0x00);
	LCD_WR_REG(0xD50B); LCD_WR_DATA(0xD2);
	LCD_WR_REG(0xD50C); LCD_WR_DATA(0x00);
	LCD_WR_REG(0xD50D); LCD_WR_DATA(0xF6);
	LCD_WR_REG(0xD50E); LCD_WR_DATA(0x01);
	LCD_WR_REG(0xD50F); LCD_WR_DATA(0x27);
	LCD_WR_REG(0xD510); LCD_WR_DATA(0x01);
	LCD_WR_REG(0xD511); LCD_WR_DATA(0x4E);
	LCD_WR_REG(0xD512); LCD_WR_DATA(0x01);
	LCD_WR_REG(0xD513); LCD_WR_DATA(0x8C);
	LCD_WR_REG(0xD514); LCD_WR_DATA(0x01);
	LCD_WR_REG(0xD515); LCD_WR_DATA(0xBE);
	LCD_WR_REG(0xD516); LCD_WR_DATA(0x02);
	LCD_WR_REG(0xD517); LCD_WR_DATA(0x0B);
	LCD_WR_REG(0xD518); LCD_WR_DATA(0x02);
	LCD_WR_REG(0xD519); LCD_WR_DATA(0x48);
	LCD_WR_REG(0xD51A); LCD_WR_DATA(0x02);
	LCD_WR_REG(0xD51B); LCD_WR_DATA(0x4A);
	LCD_WR_REG(0xD51C); LCD_WR_DATA(0x02);
	LCD_WR_REG(0xD51D); LCD_WR_DATA(0x7E);
	LCD_WR_REG(0xD51E); LCD_WR_DATA(0x02);
	LCD_WR_REG(0xD51F); LCD_WR_DATA(0xBC);
	LCD_WR_REG(0xD520); LCD_WR_DATA(0x02);
	LCD_WR_REG(0xD521); LCD_WR_DATA(0xE1);
	LCD_WR_REG(0xD522); LCD_WR_DATA(0x03);
	LCD_WR_REG(0xD523); LCD_WR_DATA(0x10);
	LCD_WR_REG(0xD524); LCD_WR_DATA(0x03);
	LCD_WR_REG(0xD525); LCD_WR_DATA(0x31);
	LCD_WR_REG(0xD526); LCD_WR_DATA(0x03);
	LCD_WR_REG(0xD527); LCD_WR_DATA(0x5A);
	LCD_WR_REG(0xD528); LCD_WR_DATA(0x03);
	LCD_WR_REG(0xD529); LCD_WR_DATA(0x73);
	LCD_WR_REG(0xD52A); LCD_WR_DATA(0x03);
	LCD_WR_REG(0xD52B); LCD_WR_DATA(0x94);
	LCD_WR_REG(0xD52C); LCD_WR_DATA(0x03);
	LCD_WR_REG(0xD52D); LCD_WR_DATA(0x9F);
	LCD_WR_REG(0xD52E); LCD_WR_DATA(0x03);
	LCD_WR_REG(0xD52F); LCD_WR_DATA(0xB3);
	LCD_WR_REG(0xD530); LCD_WR_DATA(0x03);
	LCD_WR_REG(0xD531); LCD_WR_DATA(0xB9);
	LCD_WR_REG(0xD532); LCD_WR_DATA(0x03);
	LCD_WR_REG(0xD533); LCD_WR_DATA(0xC1);

	/* GMBCTR2: Setting Gamma 2.2 Correction for Blue (Negative) */
	LCD_WR_REG(0xD600); LCD_WR_DATA(0x00);
	LCD_WR_REG(0xD601); LCD_WR_DATA(0x37);
	LCD_WR_REG(0xD602); LCD_WR_DATA(0x00);
	LCD_WR_REG(0xD603); LCD_WR_DATA(0x52);
	LCD_WR_REG(0xD604); LCD_WR_DATA(0x00);
	LCD_WR_REG(0xD605); LCD_WR_DATA(0x7B);
	LCD_WR_REG(0xD606); LCD_WR_DATA(0x00);
	LCD_WR_REG(0xD607); LCD_WR_DATA(0x99);
	LCD_WR_REG(0xD608); LCD_WR_DATA(0x00);
	LCD_WR_REG(0xD609); LCD_WR_DATA(0xB1);
	LCD_WR_REG(0xD60A); LCD_WR_DATA(0x00);
	LCD_WR_REG(0xD60B); LCD_WR_DATA(0xD2);
	LCD_WR_REG(0xD60C); LCD_WR_DATA(0x00);
	LCD_WR_REG(0xD60D); LCD_WR_DATA(0xF6);
	LCD_WR_REG(0xD60E); LCD_WR_DATA(0x01);
	LCD_WR_REG(0xD60F); LCD_WR_DATA(0x27);
	LCD_WR_REG(0xD610); LCD_WR_DATA(0x01);
	LCD_WR_REG(0xD611); LCD_WR_DATA(0x4E);
	LCD_WR_REG(0xD612); LCD_WR_DATA(0x01);
	LCD_WR_REG(0xD613); LCD_WR_DATA(0x8C);
	LCD_WR_REG(0xD614); LCD_WR_DATA(0x01);
	LCD_WR_REG(0xD615); LCD_WR_DATA(0xBE);
	LCD_WR_REG(0xD616); LCD_WR_DATA(0x02);
	LCD_WR_REG(0xD617); LCD_WR_DATA(0x0B);
	LCD_WR_REG(0xD618); LCD_WR_DATA(0x02);
	LCD_WR_REG(0xD619); LCD_WR_DATA(0x48);
	LCD_WR_REG(0xD61A); LCD_WR_DATA(0x02);
	LCD_WR_REG(0xD61B); LCD_WR_DATA(0x4A);
	LCD_WR_REG(0xD61C); LCD_WR_DATA(0x02);
	LCD_WR_REG(0xD61D); LCD_WR_DATA(0x7E);
	LCD_WR_REG(0xD61E); LCD_WR_DATA(0x02);
	LCD_WR_REG(0xD61F); LCD_WR_DATA(0xBC);
	LCD_WR_REG(0xD620); LCD_WR_DATA(0x02);
	LCD_WR_REG(0xD621); LCD_WR_DATA(0xE1);
	LCD_WR_REG(0xD622); LCD_WR_DATA(0x03);
	LCD_WR_REG(0xD623); LCD_WR_DATA(0x10);
	LCD_WR_REG(0xD624); LCD_WR_DATA(0x03);
	LCD_WR_REG(0xD625); LCD_WR_DATA(0x31);
	LCD_WR_REG(0xD626); LCD_WR_DATA(0x03);
	LCD_WR_REG(0xD627); LCD_WR_DATA(0x5A);
	LCD_WR_REG(0xD628); LCD_WR_DATA(0x03);
	LCD_WR_REG(0xD629); LCD_WR_DATA(0x73);
	LCD_WR_REG(0xD62A); LCD_WR_DATA(0x03);
	LCD_WR_REG(0xD62B); LCD_WR_DATA(0x94);
	LCD_WR_REG(0xD62C); LCD_WR_DATA(0x03);
	LCD_WR_REG(0xD62D); LCD_WR_DATA(0x9F);
	LCD_WR_REG(0xD62E); LCD_WR_DATA(0x03);
	LCD_WR_REG(0xD62F); LCD_WR_DATA(0xB3);
	LCD_WR_REG(0xD630); LCD_WR_DATA(0x03);
	LCD_WR_REG(0xD631); LCD_WR_DATA(0xB9);
	LCD_WR_REG(0xD632); LCD_WR_DATA(0x03);
	LCD_WR_REG(0xD633); LCD_WR_DATA(0xC1);

	/* MAUCCTR: Enable the Manufacture Command Set Selection - Page 0 */
	LCD_WR_REG(0xF000); LCD_WR_DATA(0x55);
	LCD_WR_REG(0xF001); LCD_WR_DATA(0xAA);
	LCD_WR_REG(0xF002); LCD_WR_DATA(0x52);
	LCD_WR_REG(0xF003); LCD_WR_DATA(0x08);
	LCD_WR_REG(0xF004); LCD_WR_DATA(0x00);

	/* RGBCTR: RGB Interface Signals Control */
	LCD_WR_REG(0xB000); LCD_WR_DATA(0x08);
	LCD_WR_REG(0xB001); LCD_WR_DATA(0x05);
	LCD_WR_REG(0xB002); LCD_WR_DATA(0x02);
	LCD_WR_REG(0xB003); LCD_WR_DATA(0x05);
	LCD_WR_REG(0xB004); LCD_WR_DATA(0x02);

	/* SDHDTCTR: Source Output Data Hold Time Control */
	LCD_WR_REG(0xB600); LCD_WR_DATA(0x08);

	/* GSEQCTR: EQ Control Function for Gate Signals */
	LCD_WR_REG(0xB700); LCD_WR_DATA(0x00);
	LCD_WR_REG(0xB701); LCD_WR_DATA(0x00);

	/* SDEQCTR: EQ Control Function for Source Driver */
	LCD_WR_REG(0xB800); LCD_WR_DATA(0x01);
	LCD_WR_REG(0xB801); LCD_WR_DATA(0x05);
	LCD_WR_REG(0xB802); LCD_WR_DATA(0x05);
	LCD_WR_REG(0xB803); LCD_WR_DATA(0x05);
}

/* Exported functions --------------------------------------------------------*/
void NT35510_Init(void)
{
	/* Perform a hardware reset */
	HAL_GPIO_WritePin(LCD_RST_GPIO_Port, LCD_RST_Pin, GPIO_PIN_SET);
	LCD_Delay(100);
	HAL_GPIO_WritePin(LCD_RST_GPIO_Port, LCD_RST_Pin, GPIO_PIN_RESET);
	LCD_Delay(100);
	HAL_GPIO_WritePin(LCD_RST_GPIO_Port, LCD_RST_Pin, GPIO_PIN_SET);
	LCD_Delay(100);

	NT35510_Gamma_Correction();

	/* DPFRCTR1: Display Timing Control in Normal / Idle Off Mode */
	LCD_WR_REG(0xBD00); LCD_WR_DATA(0x01); //19.45us
	LCD_WR_REG(0xBD01); LCD_WR_DATA(0x84);
	LCD_WR_REG(0xBD02); LCD_WR_DATA(0x07); // 7 lines
	LCD_WR_REG(0xBD03); LCD_WR_DATA(0x31); // 49 lines

	/* Normal Mode On */
	LCD_WR_REG(NT35510_CMD_NORON);

	/* Tearing Effect On */
//	LCD_WR_REG(NT35510_CMD_TEEON);
//	LCD_WR_DATA(0x00);
//
//	/* Set Tear Scan Line Mode */
//	LCD_WR_REG(NT35510_CMD_STESL);
//	LCD_WR_DATA(0x00);
//	LCD_WR_REG(NT35510_CMD_STESL + 1);
//	LCD_WR_DATA(0x00);

	/* Change the color mode to RG565 */
	LCD_WR_REG(NT35510_CMD_COLMOD);
	LCD_WR_DATA(NT35510_COLMOD_RGB565);

//	LCD_WR_REG(NT35510_CMD_MADCTL);
//	LCD_WR_DATA(0x14);

	/* Send the Sleep Out Command */
	LCD_WR_REG(NT35510_CMD_SLPOUT);

	LCD_Delay(120);

	/* Turn the display on */
	LCD_WR_REG(NT35510_CMD_DISPON);

#ifdef DMA_HANDLE
	DMA_HANDLE.XferCpltCallback = DMA_TXCALLBACK;
#endif
}

void NT35510_SetWindow(uint16_t x, uint16_t y, uint16_t sizex, uint16_t sizey)
{
	LCD_WR_REG(NT35510_CMD_CASET);
	LCD_WR_DATA((x & 0xFF00) >> 8);
	LCD_WR_REG((NT35510_CMD_CASET) + 1);
	LCD_WR_DATA(x & 0x00FF);
	LCD_WR_REG((NT35510_CMD_CASET) + 2);
	LCD_WR_DATA(((x + sizex) & 0xFF00) >> 8);
	LCD_WR_REG((NT35510_CMD_CASET) + 3);
	LCD_WR_DATA((x + sizex - 1) & 0x00FF);

	LCD_WR_REG(NT35510_CMD_RASET);
	LCD_WR_DATA((y & 0xFF00) >> 8);
	LCD_WR_REG((NT35510_CMD_RASET) + 1);
	LCD_WR_DATA(y & 0x00FF);
	LCD_WR_REG((NT35510_CMD_RASET) + 2);
	LCD_WR_DATA(((y + sizey) & 0xFF00) >> 8);
	LCD_WR_REG((NT35510_CMD_RASET) + 3);
	LCD_WR_DATA((y + sizey - 1) & 0x00FF);
}

uint16_t NT35510_GetLine(void)
{
	uint32_t line;

	LCD_WR_REG(NT35510_CMD_GSL);
	line = LCD_RD_DATA() << 8;
	LCD_WR_REG(NT35510_CMD_GSL + 1);
	line |= LCD_RD_DATA();

	return line;
}

void NT35510_DMAWrite(uint16_t *pixels, uint16_t x, uint16_t y, uint16_t sizex, uint16_t sizey)
{
	__isTranmittingBlock = SET;

	NT35510_SetWindow(x, y, sizex, sizey);

	DMA_HANDLE.Instance->CMAR = (uint32_t)LCD_RAM;
	DMA_HANDLE.Instance->CPAR = (uint32_t)pixels;
	DMA_HANDLE.Instance->CNDTR = sizex * sizey;

	__HAL_DMA_ENABLE_IT(&DMA_HANDLE, DMA_IT_TC);

	LCD_WR_REG(NT35510_CMD_RAMWR);

	__HAL_DMA_ENABLE(&DMA_HANDLE);
}

void NT35510_FadeIn(uint8_t Delay)
{
	for(uint16_t i = 0; i < 128; i++)
	{
		LL_TIM_OC_SetCompareCH1(TIM_HANDLE, fade[i]);
		LCD_Delay(Delay);
	}
}

void NT35510_FadeOut(uint8_t Delay)
{
	for(uint16_t i = 128; i > 0; i--)
	{
		LL_TIM_OC_SetCompareCH1(TIM_HANDLE, fade[i]);
		LCD_Delay(Delay);
	}
}
