Paulo-Pecegueiro/Bode_Analyzer_STM32G474/Firmware/TCC_BODE_ANALYZER_G474/Core/Src/fmc.c

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

/* Includes ------------------------------------------------------------------*/
#include "fmc.h"

SRAM_HandleTypeDef hsram1;

/* FMC initialization function */
void MX_FMC_Init(void)
{
  FMC_NORSRAM_TimingTypeDef Timing = {0};
  FMC_NORSRAM_TimingTypeDef ExtTiming = {0};

  /** Perform the SRAM1 memory initialization sequence
  */
  hsram1.Instance = FMC_NORSRAM_DEVICE;
  hsram1.Extended = FMC_NORSRAM_EXTENDED_DEVICE;
  /* hsram1.Init */
  hsram1.Init.NSBank = FMC_NORSRAM_BANK1;
  hsram1.Init.DataAddressMux = FMC_DATA_ADDRESS_MUX_DISABLE;
  hsram1.Init.MemoryType = FMC_MEMORY_TYPE_SRAM;
  hsram1.Init.MemoryDataWidth = FMC_NORSRAM_MEM_BUS_WIDTH_16;
  hsram1.Init.BurstAccessMode = FMC_BURST_ACCESS_MODE_DISABLE;
  hsram1.Init.WaitSignalPolarity = FMC_WAIT_SIGNAL_POLARITY_LOW;
  hsram1.Init.WaitSignalActive = FMC_WAIT_TIMING_BEFORE_WS;
  hsram1.Init.WriteOperation = FMC_WRITE_OPERATION_ENABLE;
  hsram1.Init.WaitSignal = FMC_WAIT_SIGNAL_DISABLE;
  hsram1.Init.ExtendedMode = FMC_EXTENDED_MODE_ENABLE;
  hsram1.Init.AsynchronousWait = FMC_ASYNCHRONOUS_WAIT_DISABLE;
  hsram1.Init.WriteBurst = FMC_WRITE_BURST_DISABLE;
  hsram1.Init.ContinuousClock = FMC_CONTINUOUS_CLOCK_SYNC_ONLY;
  hsram1.Init.WriteFifo = FMC_WRITE_FIFO_ENABLE;
  hsram1.Init.NBLSetupTime = 0;
  hsram1.Init.PageSize = FMC_PAGE_SIZE_NONE;
  hsram1.Init.MaxChipSelectPulse = DISABLE;
  /* Timing */
  Timing.AddressSetupTime = 0;
  Timing.AddressHoldTime = 15;
  Timing.DataSetupTime = 1;
  Timing.DataHoldTime = 0;
  Timing.BusTurnAroundDuration = 15;
  Timing.CLKDivision = 16;
  Timing.DataLatency = 17;
  Timing.AccessMode = FMC_ACCESS_MODE_A;
  /* ExtTiming */
  ExtTiming.AddressSetupTime = 0;
  ExtTiming.AddressHoldTime = 15;
  ExtTiming.DataSetupTime = 1;
  ExtTiming.DataHoldTime = 0;
  ExtTiming.BusTurnAroundDuration = 15;
  ExtTiming.CLKDivision = 16;
  ExtTiming.DataLatency = 17;
  ExtTiming.AccessMode = FMC_ACCESS_MODE_A;

  if (HAL_SRAM_Init(&hsram1, &Timing, &ExtTiming) != HAL_OK)
  {
    Error_Handler( );
  }

  /* USER CODE BEGIN FMC_Init 2 */
	/* Timing */
	Timing.AddressSetupTime = 15;
	Timing.AddressHoldTime = 15;
	Timing.DataSetupTime = 15;
	Timing.CLKDivision = 2;
	Timing.DataLatency = 2;
	/* ExtTiming */
	ExtTiming.AddressSetupTime = 0;
	ExtTiming.AddressHoldTime = 1;
	ExtTiming.DataSetupTime = 0;
	if (HAL_SRAM_Init(&hsram1, &Timing, &ExtTiming) != HAL_OK)
	{
		Error_Handler( );
	}
  /* USER CODE END FMC_Init 2 */
}

static uint32_t FMC_Initialized = 0;

static void HAL_FMC_MspInit(void){
  GPIO_InitTypeDef GPIO_InitStruct = {0};
  if (FMC_Initialized) {
    return;
  }
  FMC_Initialized = 1;

  /* Peripheral clock enable */
  __HAL_RCC_FMC_CLK_ENABLE();

  /** FMC GPIO Configuration
  PE7   ------> FMC_D4
  PE8   ------> FMC_D5
  PE9   ------> FMC_D6
  PE10   ------> FMC_D7
  PE11   ------> FMC_D8
  PE12   ------> FMC_D9
  PE13   ------> FMC_D10
  PE14   ------> FMC_D11
  PE15   ------> FMC_D12
  PD8   ------> FMC_D13
  PD9   ------> FMC_D14
  PD10   ------> FMC_D15
  PD13   ------> FMC_A18
  PD14   ------> FMC_D0
  PD15   ------> FMC_D1
  PD0   ------> FMC_D2
  PD1   ------> FMC_D3
  PD4   ------> FMC_NOE
  PD5   ------> FMC_NWE
  PD7   ------> FMC_NE1
  */
  /* GPIO_InitStruct */
  GPIO_InitStruct.Pin = GPIO_PIN_7|GPIO_PIN_8|GPIO_PIN_9|GPIO_PIN_10
                          |GPIO_PIN_11|GPIO_PIN_12|GPIO_PIN_13|GPIO_PIN_14
                          |GPIO_PIN_15;
  GPIO_InitStruct.Mode = GPIO_MODE_AF_PP;
  GPIO_InitStruct.Pull = GPIO_NOPULL;
  GPIO_InitStruct.Speed = GPIO_SPEED_FREQ_VERY_HIGH;
  GPIO_InitStruct.Alternate = GPIO_AF12_FMC;

  HAL_GPIO_Init(GPIOE, &GPIO_InitStruct);

  /* GPIO_InitStruct */
  GPIO_InitStruct.Pin = GPIO_PIN_8|GPIO_PIN_9|GPIO_PIN_10|GPIO_PIN_13
                          |GPIO_PIN_14|GPIO_PIN_15|GPIO_PIN_0|GPIO_PIN_1
                          |GPIO_PIN_4|GPIO_PIN_5|GPIO_PIN_7;
  GPIO_InitStruct.Mode = GPIO_MODE_AF_PP;
  GPIO_InitStruct.Pull = GPIO_NOPULL;
  GPIO_InitStruct.Speed = GPIO_SPEED_FREQ_VERY_HIGH;
  GPIO_InitStruct.Alternate = GPIO_AF12_FMC;

  HAL_GPIO_Init(GPIOD, &GPIO_InitStruct);

}

void HAL_SRAM_MspInit(SRAM_HandleTypeDef* sramHandle){
  HAL_FMC_MspInit();
}

static uint32_t FMC_DeInitialized = 0;

static void HAL_FMC_MspDeInit(void){
  if (FMC_DeInitialized) {
    return;
  }
  FMC_DeInitialized = 1;
  /* Peripheral clock enable */
  __HAL_RCC_FMC_CLK_DISABLE();

  /** FMC GPIO Configuration
  PE7   ------> FMC_D4
  PE8   ------> FMC_D5
  PE9   ------> FMC_D6
  PE10   ------> FMC_D7
  PE11   ------> FMC_D8
  PE12   ------> FMC_D9
  PE13   ------> FMC_D10
  PE14   ------> FMC_D11
  PE15   ------> FMC_D12
  PD8   ------> FMC_D13
  PD9   ------> FMC_D14
  PD10   ------> FMC_D15
  PD13   ------> FMC_A18
  PD14   ------> FMC_D0
  PD15   ------> FMC_D1
  PD0   ------> FMC_D2
  PD1   ------> FMC_D3
  PD4   ------> FMC_NOE
  PD5   ------> FMC_NWE
  PD7   ------> FMC_NE1
  */

  HAL_GPIO_DeInit(GPIOE, GPIO_PIN_7|GPIO_PIN_8|GPIO_PIN_9|GPIO_PIN_10
                          |GPIO_PIN_11|GPIO_PIN_12|GPIO_PIN_13|GPIO_PIN_14
                          |GPIO_PIN_15);

  HAL_GPIO_DeInit(GPIOD, GPIO_PIN_8|GPIO_PIN_9|GPIO_PIN_10|GPIO_PIN_13
                          |GPIO_PIN_14|GPIO_PIN_15|GPIO_PIN_0|GPIO_PIN_1
                          |GPIO_PIN_4|GPIO_PIN_5|GPIO_PIN_7);

}

void HAL_SRAM_MspDeInit(SRAM_HandleTypeDef* sramHandle){
  HAL_FMC_MspDeInit();
}
/**
  * @}
  */

/**
  * @}
  */
