Paulo-Pecegueiro/Bode_Analyzer_STM32G474/Firmware/TCC_BODE_ANALYZER_G474/Core/Src/i2c.c

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
/* Includes ------------------------------------------------------------------*/
#include "i2c.h"

/* USER CODE BEGIN 0 */
#include "GT9147.h"
extern FlagStatus IsTouchInitialized;
/* USER CODE END 0 */

I2C_HandleTypeDef hi2c4;

/* I2C4 init function */
void MX_I2C4_Init(void)
{

  hi2c4.Instance = I2C4;
  hi2c4.Init.Timing = 0x30807DBB;
  hi2c4.Init.OwnAddress1 = 0;
  hi2c4.Init.AddressingMode = I2C_ADDRESSINGMODE_7BIT;
  hi2c4.Init.DualAddressMode = I2C_DUALADDRESS_DISABLE;
  hi2c4.Init.OwnAddress2 = 0;
  hi2c4.Init.OwnAddress2Masks = I2C_OA2_NOMASK;
  hi2c4.Init.GeneralCallMode = I2C_GENERALCALL_DISABLE;
  hi2c4.Init.NoStretchMode = I2C_NOSTRETCH_DISABLE;
  if (HAL_I2C_Init(&hi2c4) != HAL_OK)
  {
    Error_Handler();
  }

  /** Configure Analogue filter
  */
  if (HAL_I2CEx_ConfigAnalogFilter(&hi2c4, I2C_ANALOGFILTER_ENABLE) != HAL_OK)
  {
    Error_Handler();
  }

  /** Configure Digital filter
  */
  if (HAL_I2CEx_ConfigDigitalFilter(&hi2c4, 0) != HAL_OK)
  {
    Error_Handler();
  }
  /* USER CODE BEGIN I2C4_Init 2 */
	/* Private variables */
	uint8_t counter = 0;

	/* Check if touch is initialized and try it 10 times */
	while(IsTouchInitialized == RESET && counter < 10)
	{
		/* Toggle the I2C Address */
		if(ICAddress == SET)
			ICAddress = RESET;
		else
			ICAddress = SET;

		/* Reset the Device */
		GT9147_Reset();

		/* Wait 10ms until the device is ready */
		HAL_Delay(10);

		/* Try to initialize the Touch Controller */
		if(GT9147_Init() == GT9147_OK)
			IsTouchInitialized = SET;

		/* Increment the counter */
		counter++;
	}
  /* USER CODE END I2C4_Init 2 */

}

void HAL_I2C_MspInit(I2C_HandleTypeDef* i2cHandle)
{

  GPIO_InitTypeDef GPIO_InitStruct = {0};
  RCC_PeriphCLKInitTypeDef PeriphClkInit = {0};
  if(i2cHandle->Instance==I2C4)
  {
  /** Initializes the peripherals clocks
  */
    PeriphClkInit.PeriphClockSelection = RCC_PERIPHCLK_I2C4;
    PeriphClkInit.I2c4ClockSelection = RCC_I2C4CLKSOURCE_PCLK1;
    if (HAL_RCCEx_PeriphCLKConfig(&PeriphClkInit) != HAL_OK)
    {
      Error_Handler();
    }

    __HAL_RCC_GPIOC_CLK_ENABLE();
    /**I2C4 GPIO Configuration
    PC6     ------> I2C4_SCL
    PC7     ------> I2C4_SDA
    */
    GPIO_InitStruct.Pin = GPIO_PIN_6|GPIO_PIN_7;
    GPIO_InitStruct.Mode = GPIO_MODE_AF_OD;
    GPIO_InitStruct.Pull = GPIO_PULLUP;
    GPIO_InitStruct.Speed = GPIO_SPEED_FREQ_VERY_HIGH;
    GPIO_InitStruct.Alternate = GPIO_AF8_I2C4;
    HAL_GPIO_Init(GPIOC, &GPIO_InitStruct);

    /* I2C4 clock enable */
    __HAL_RCC_I2C4_CLK_ENABLE();
  }
}

void HAL_I2C_MspDeInit(I2C_HandleTypeDef* i2cHandle)
{

  if(i2cHandle->Instance==I2C4)
  {
    /* Peripheral clock disable */
    __HAL_RCC_I2C4_CLK_DISABLE();

    /**I2C4 GPIO Configuration
    PC6     ------> I2C4_SCL
    PC7     ------> I2C4_SDA
    */
    HAL_GPIO_DeInit(GPIOC, GPIO_PIN_6);

    HAL_GPIO_DeInit(GPIOC, GPIO_PIN_7);

  }
}
