Paulo-Pecegueiro/Bode_Analyzer_STM32G474/Firmware/TCC_BODE_ANALYZER_G474/Application/Inc/app_analyzer.h

/*
 * app_analyzer.h
 *
 *  Created on: Dec 5, 2023
 *      Author: daniel, paulo
 */

#ifndef INC_APP_ANALYZER_H_
#define INC_APP_ANALYZER_H_
/* Exported Includes */
#include "main.h"
#include "app_main.h"

/* Exported Function Prototypes */
void APP_ProcessFrequencyData(Frequencies_e frequency, uint16_t* pDataOut, uint16_t* pDataIn);

#endif /* INC_APP_ANALYZER_H_ */
