Paulo-Pecegueiro/Bode_Analyzer_STM32G474/Firmware/TCC_BODE_ANALYZER_G474/Application/Inc/app_compensation.h

/*
 * app_compensation.h
 *
 *  Created on: 9 de dez de 2023
 *      Author: daniel, paulo
 */

#ifndef INC_APP_COMPENSATION_H_
#define INC_APP_COMPENSATION_H_

const float compensation_phase_values[38] =
{
		-0.352880865, -0.153369144, -0.0224121101, 0.0284545906, 0.0884399414,
		0.130297855, 0.161718756, 0.153588861, 0.161499023, 0.1415039,
		0.191162109, 0.180615231, 0.193908691, 0.190502927, 0.191821292,
		0.199072272, 0.175891116, 0.185668945, 0.193469241, 0.188964844,
		0.208520502, 0.195007324, 0.193359375, 0.198632807, 0.20280762,
		0.188085943, 0.18182373, 0.150952145, -0.477685541, -1.4629395,
		0.0968994126, -2.94071054, -3.66899419, -4.29433584, -4.9524169,
		-5.56951904, -6.24847412, -13.013525
};

const float compensation_gain_values[38] =
{
		0.00409730012, -0.0248134583, -0.0383112133, -0.0458775014, -0.0478705764,
		-0.038698107, -0.0391276591, -0.0408606641, -0.0395572372, -0.0391235016,
		-0.0395671204, -0.0386918671, -0.0399967246, -0.0386918671, -0.0386918671,
		-0.0404331051, -0.0391255841, -0.0404331051, -0.0395613983, -0.0395613983,
		-0.0391276591, -0.040866904, -0.0395634808, -0.0399967246, -0.0391276591,
		-0.0399993211, -0.0399993211, -0.0408689864, -0.0395692065, -0.0386996642,
		-0.0400097258, -0.0382711701, -0.0391489826, -0.0382872932, -0.0374298468,
		-0.0365704, -0.0365807973, -0.126732618
};
#endif /* INC_APP_COMPENSATION_H_ */
