Paulo-Pecegueiro/Bode_Analyzer_STM32G474/Firmware/TCC_BODE_ANALYZER_G474/Application/Inc/app_constants.h

/*
 * app_constants.h
 *
 *  Created on: Dec 2, 2023
 *      Author: daniel, paulo
 */

#ifndef INC_APP_CONSTANTS_H_
#define INC_APP_CONSTANTS_H_

#include "main.h"

uint16_t sinewave[100] = {
		2047, 2175, 2303, 2430, 2556, 2679, 2800, 2918, 3033, 3144, 3250,
		3352, 3448, 3539, 3624, 3703, 3776, 3841, 3900, 3951, 3994,
		4030, 4058, 4078, 4090, 4094, 4090, 4078, 4058, 4030, 3994,
		3951, 3900, 3841, 3776, 3703, 3625, 3540, 3449, 3352, 3250,
		3144, 3033, 2919, 2801, 2680, 2556, 2430, 2303, 2175, 2047,
		1918, 1790, 1663, 1537, 1414, 1293, 1175, 1060, 949, 843,
		741, 645, 554, 469, 390, 317, 252, 194, 142, 99,
		63, 35, 15, 3, 0, 3, 15, 35, 63, 99,
		142, 193, 252, 317, 389, 468, 553, 644, 741, 842,
		949, 1060, 1174, 1292, 1413, 1537, 1662, 1789, 1918
};

const uint32_t timReload[38] =
{
		39999, 19999, 13332, 9999, 7999, 13332, 11427, 9999, 8887, 7999,
		3999, 2665, 1999, 1599, 2665, 2284, 1999, 1776, 1599, 799,
		532, 399, 319, 1065, 913, 799, 710, 639, 319, 212,
		159, 128, 105, 90, 79, 70, 63, 31
};

const uint32_t timPrescalers[38] =
{
		31, 31, 31, 31, 31,
		15, 15, 15, 15, 15, 15, 15, 15, 15,
		7, 7, 7, 7, 7, 7, 7, 7, 7,
		1, 1, 1, 1, 1, 1, 1, 1, 1, 1, 1, 1, 1, 1, 1
};

const uint32_t repetition[38] =
{
		10, 10, 10, 10, 10, 10, 10, 10, 10,
		10, 20, 30, 40, 50, 60, 70, 80, 90,
		100, 200, 300, 400, 500, 600, 700, 800, 900,
		1000, 2000, 3000, 4000, 5000, 6000, 7000, 8000, 9000,
		10000, 20000
};
#endif /* INC_APP_CONSTANTS_H_ */
