Paulo-Pecegueiro/Bode_Analyzer_STM32G474/Firmware/TCC_BODE_ANALYZER_G474/Application/Inc/app_filesystem.h

/*
 * app_filesystem.h
 *
 *  Created on: Dec 3, 2023
 *      Author: daniel, paulo
 */

#ifndef INC_APP_FILESYSTEM_H_
#define INC_APP_FILESYSTEM_H_

/* Exported includes */
#include "main.h"
#include "fat.h"

/* Exported Function Prototypes */
void APP_FileSystemInit(void);
void APP_FormatFS(void);
void APP_ReadFileContent(void);
void APP_WriteFileContent(void);

/* Exported variables */
extern const uint8_t FileHeader[];

#endif /* INC_APP_FILESYSTEM_H_ */
