Paulo-Pecegueiro/Bode_Analyzer_STM32G474/(notices)

Notices in the files:
Firmware/TCC_BODE_ANALYZER_G474/Core/Src/app_freertos.c:
Copyright (c) 2023 STMicroelectronics.
All rights reserved.
This software is licensed under terms that can be found in the LICENSE file
